TobleMiner/ringlight/README.md

Ring light
==========

Just a quick and dirty, JLCPCB assembly ready ring light with adjustable brightness and color temperature.

Entirely untested. Use at your own risk.
