TobleMiner/ringlight/microscope-light.kicad_pcb

## KiCad design microscope-light.kicad_pcb (2020-12-30)

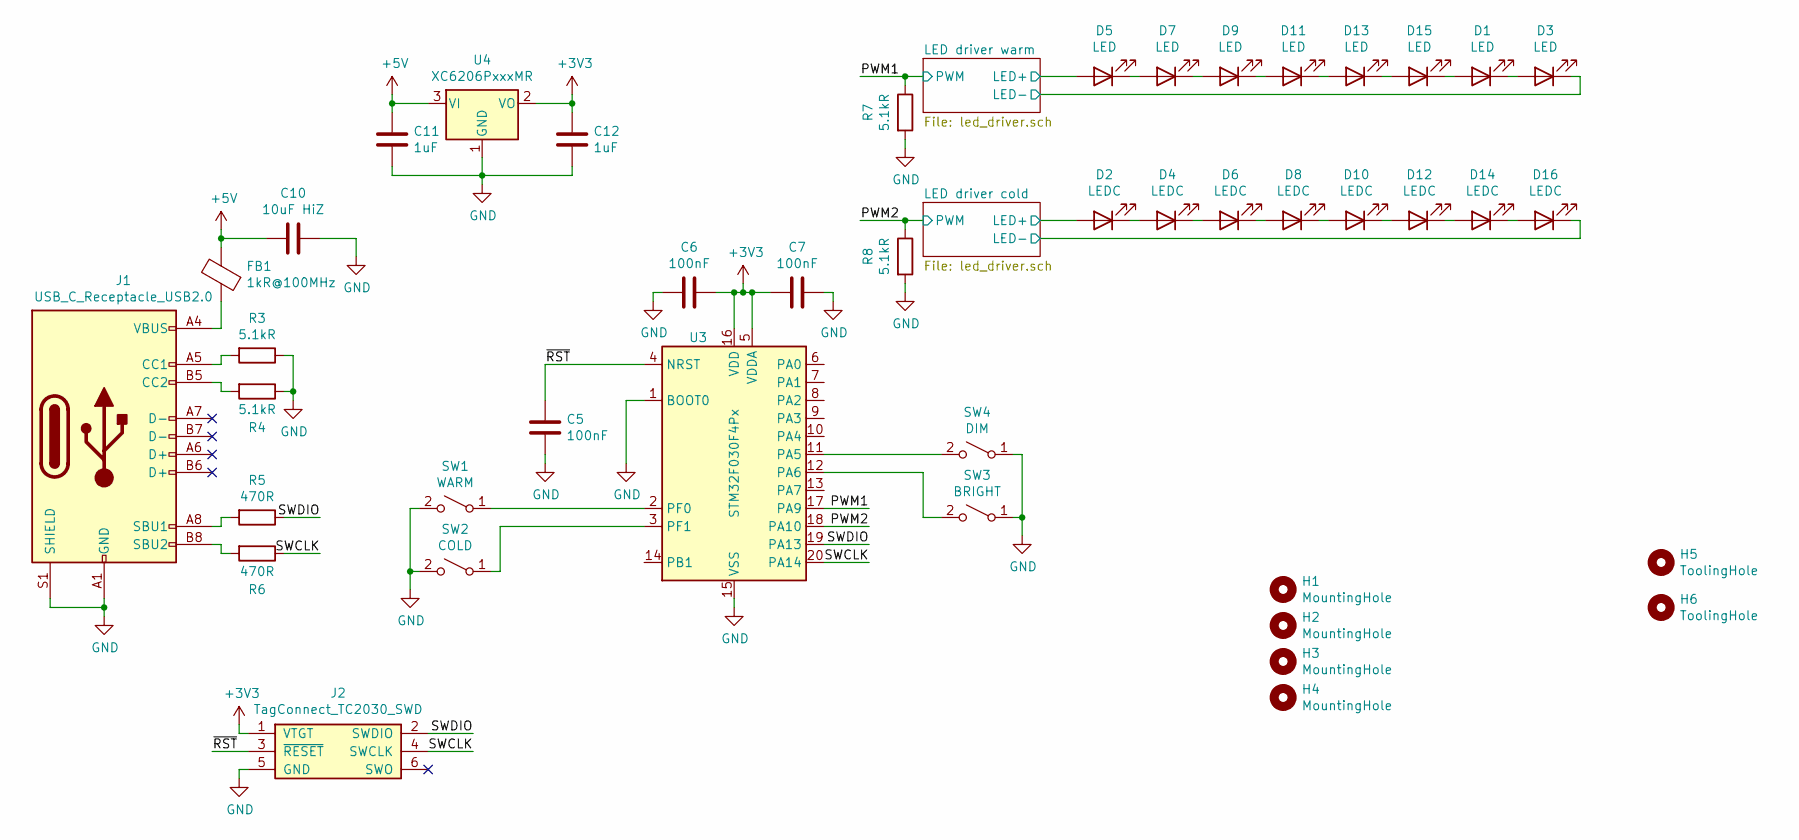
[picture p4: schematic microscope-light.sch, ring light]

Parts:
C5, C6, C7: 100nF; C_0402_1005Metric; LCSC C1525
C10: 10uF HiZ; C_1206_3216Metric; LCSC C13585
C11, C12: 1uF; C_0402_1005Metric; LCSC C52923
D1, D3, D5, D7, D9, D11, D13, D15: LED; PLCC-2; LCSC C210310
D2, D4, D6, D8, D10, D12, D14, D16: LEDC; PLCC-2; LCSC C210314
FB1: 1kR@100MHz; L_1206_3216Metric; LCSC C139169
H1, H2, H3, H4: MountingHole; MountingHole_4.3mm_M4
H5, H6: ToolingHole; ToolingHole_JLCSMT
J1: USB_C_Receptacle_USB2.0; USB_C_Receptacle_Palconn_UTC16-G
J2: TagConnect_TC2030_SWD; Tag-Connect_TC2030-IDC-NL_2x03_P1.27mm_Vertical
R3, R4, R7, R8: 5.1kR; R_0402_1005Metric; LCSC C25905
R5, R6: 470R; R_0402_1005Metric; LCSC C25117
SW1: WARM; TS-1187A-X-X-X; LCSC C318889
SW2: COLD; TS-1187A-X-X-X; LCSC C318889
SW3: BRIGHT; TS-1187A-X-X-X; LCSC C318889
SW4: DIM; TS-1187A-X-X-X; LCSC C318889
U3: STM32F030F4Px; TSSOP-20_4.4x6.5mm_P0.65mm; LCSC C89040
U4: XC6206PxxxMR; SOT-23; LCSC C5446

Connections:
+3V3: C6.1, C7.2, C12.1, J2.1 (VTGT), U3.5 (VDDA), U3.16 (VDD), U4.2 (VO)
+5V: C10.2, C11.1, FB1.2, U4.3 (VI); also elsewhere on the board
/LED driver cold/LED+: D2.2 (A); also elsewhere on the board
/LED driver cold/LED-: D16.1 (K); also elsewhere on the board
/LED driver warm/LED+: D5.2 (A); also elsewhere on the board
/LED driver warm/LED-: D3.1 (K); also elsewhere on the board
/PWM1: R7.1, U3.17 (PA9); also elsewhere on the board
/PWM2: R8.1, U3.18 (PA10); also elsewhere on the board
/SWCLK: J2.4 (SWCLK), R6.1, U3.20 (PA14)
/SWDIO: J2.2 (SWDIO), R5.1, U3.19 (PA13)
/~RST: C5.2, J2.3 (~RESET), U3.4 (NRST)
GND: C5.1, C6.2, C7.1, C10.1, C11.2, C12.2, J1.A1 (GND), J1.A12 (GND), J1.B1 (GND), J1.B12 (GND), J1.S1 (SHIELD), J2.5 (GND), R3.1, R4.1, R7.2, R8.2, SW1.2 (B), SW2.2 (B), SW3.1 (A), SW4.1 (A), U3.1 (BOOT0), U3.15 (VSS), U4.1 (GND); also elsewhere on the board
unnamed: D1.1 (K), D3.2 (A)
unnamed: D1.2 (A), D15.1 (K)
unnamed: D2.1 (K), D4.2 (A)
unnamed: D4.1 (K), D6.2 (A)
unnamed: D5.1 (K), D7.2 (A)
unnamed: D6.1 (K), D8.2 (A)
unnamed: D7.1 (K), D9.2 (A)
unnamed: D10.1 (K), D12.2 (A)
unnamed: D8.1 (K), D10.2 (A)
unnamed: D11.1 (K), D13.2 (A)
unnamed: D9.1 (K), D11.2 (A)
unnamed: D12.1 (K), D14.2 (A)
unnamed: D13.1 (K), D15.2 (A)
unnamed: D14.1 (K), D16.2 (A)
unnamed: FB1.1, J1.A4 (VBUS), J1.A9 (VBUS), J1.B4 (VBUS), J1.B9 (VBUS)
unnamed: J1.A5 (CC1), R3.2
unnamed: J1.A8 (SBU1), R5.2
unnamed: J1.B5 (CC2), R4.2
unnamed: J1.B8 (SBU2), R6.2
unnamed: SW1.1 (A), U3.2 (PF0)
unnamed: SW2.1 (A), U3.3 (PF1)
unnamed: SW3.2 (B), U3.12 (PA6)
unnamed: SW4.2 (B), U3.11 (PA5)

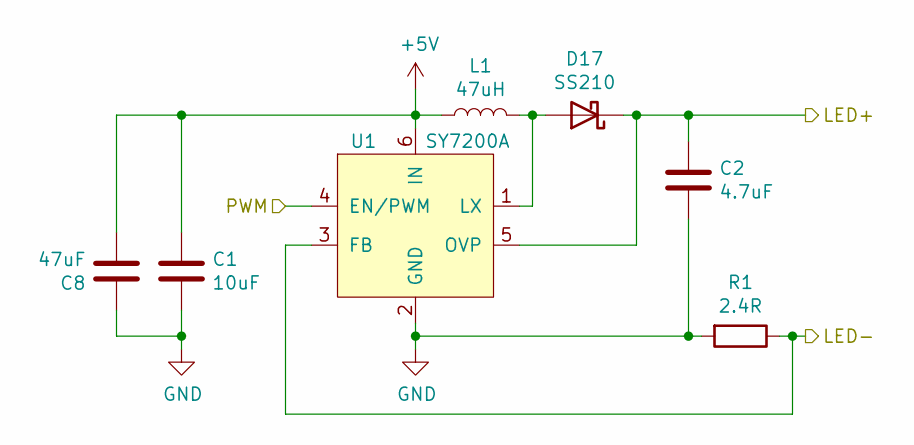
[picture p5: schematic led_driver.sch]

Parts:
C1: 10uF; C_0805_2012Metric; LCSC C15850
C2: 4.7uF; C_1206_3216Metric; LCSC C29823
C8: 47uF; C_1206_3216Metric; LCSC C96123
D17: SS210; D_SMA; LCSC C14996
L1: 47uH; MWSA0603S; LCSC C408455
R1: 2.4R; R_0805_2012Metric; LCSC C17528
U1: SY7200A; SOT-23-6; LCSC C107309

Connections:
+5V: C1.1, C8.2, L1.1, U1.6 (IN); also elsewhere on the board
/LED driver warm/LED+: C2.1, D17.1 (K), U1.5 (OVP); also elsewhere on the board
/LED driver warm/LED-: R1.1, U1.3 (FB); also elsewhere on the board
/PWM1: U1.4 (EN/PWM); also elsewhere on the board
GND: C1.2, C2.2, C8.1, R1.2, U1.2 (GND); also elsewhere on the board
unnamed: D17.2 (A), L1.2, U1.1 (LX)

Parts of its further copies:
C3: 10uF; C_0805_2012Metric; LCSC C15850
C4: 4.7uF; C_1206_3216Metric; LCSC C29823
C9: 47uF; C_1206_3216Metric; LCSC C96123
D18: SS210; D_SMA; LCSC C14996
L2: 47uH; MWSA0603S; LCSC C408455
R2: 2.4R; R_0805_2012Metric; LCSC C17528
U2: SY7200A; SOT-23-6; LCSC C107309

Connections of its further copies:
+5V: C3.1, C9.2, L2.1, U2.6 (IN); also elsewhere on the board
/LED driver cold/LED+: C4.1, D18.1 (K), U2.5 (OVP); also elsewhere on the board
/LED driver cold/LED-: R2.1, U2.3 (FB); also elsewhere on the board
/PWM2: U2.4 (EN/PWM); also elsewhere on the board
GND: C3.2, C4.2, C9.1, R2.2, U2.2 (GND); also elsewhere on the board
unnamed: D18.2 (A), L2.2, U2.1 (LX)

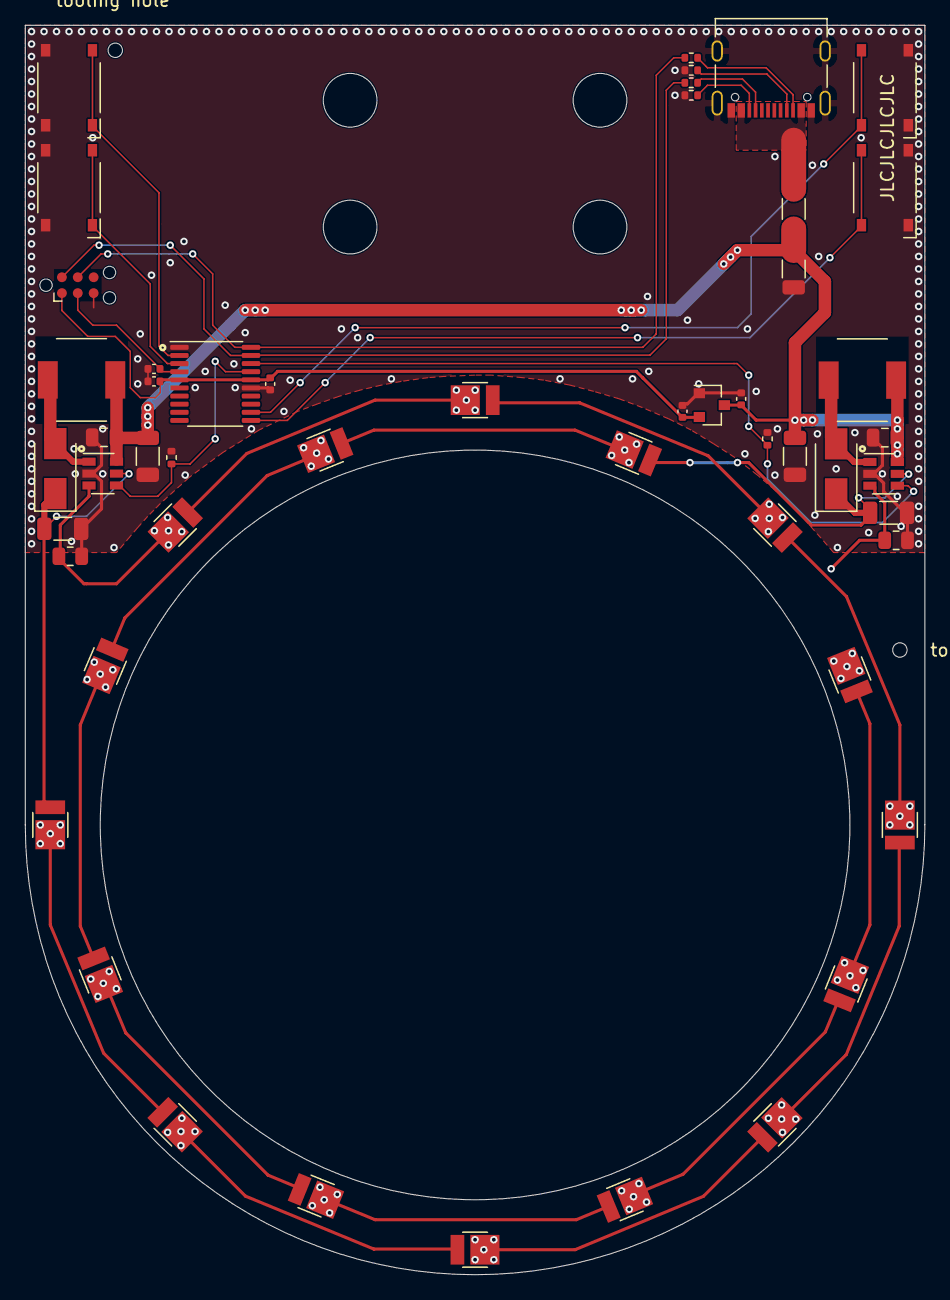
[picture p6: board microscope-light.kicad_pcb from above]

Board: 2 copper layers, 72.0 x 100.0 mm, 57 parts (0 on the bottom side), 37 nets.
