TobleMiner/ringlight/(commit log)

2020-12-30 Hide fp references
    [microscope-light.kicad_pcb]
2020-12-30 Add fabrication features
    [microscope-light.kicad_pcb, microscope-light.sch]
2020-12-30 Add schematic export
    [led_driver.sch, microscope-light.kicad_pcb, microscope-light.sch]
2020-12-30 Add fabrication files
    [microscope-light_bom_jlc.csv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]
